JohnMismash/ECESeniorCapstone/Raspberry_Pi/ReadMe.txt

The program to run is mainProgram.py. To do this, python3 mainProgram.py

Wire Management:
Break Beam Sensor is using 
	GPIO 0, pin 11
	5 VDC, pin 2
	Ground, pin 6

Alarm Wires:
Alarm System is using:
	3.3 VDC Power, pin 1 
	GPIO 8, pin 3
	GPIO 9, pin 5
	Ground, pin 11
