JohnMismash/ECESeniorCapstone/Motor Calculations/PCB Planning.pdf

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

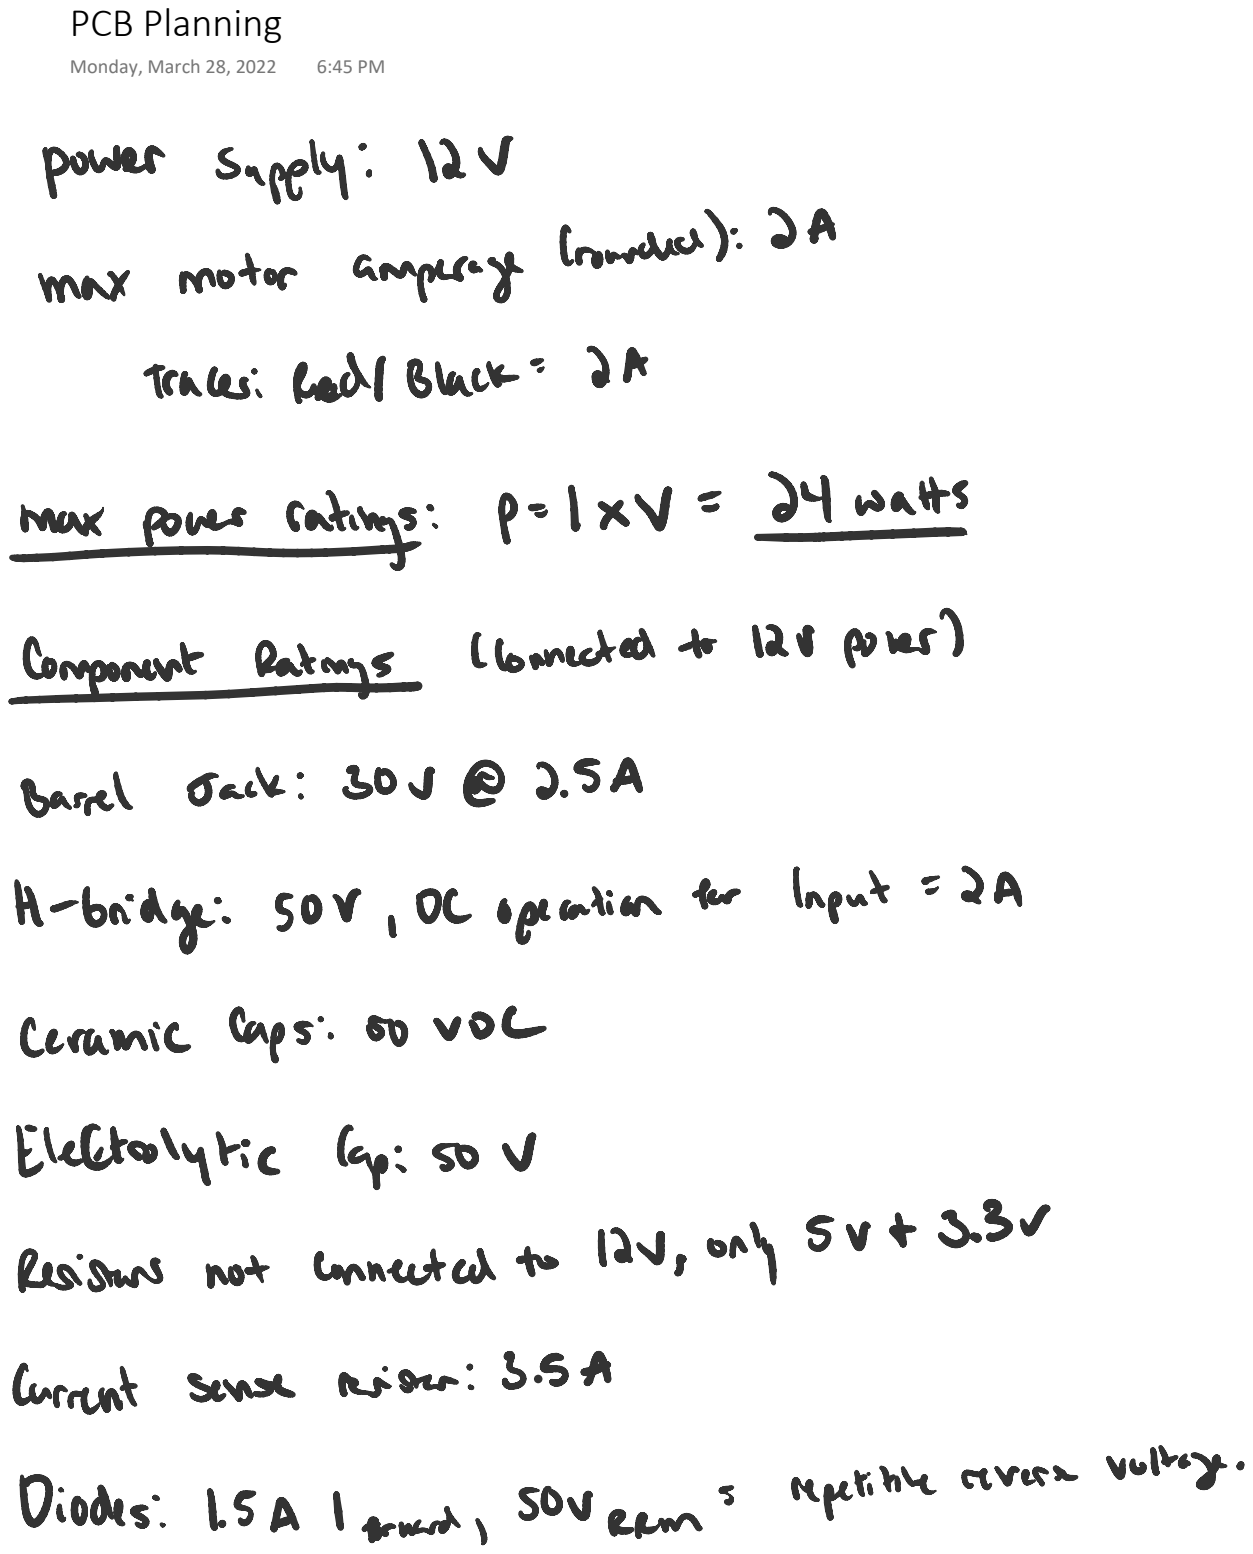
[picture p4: page 1]

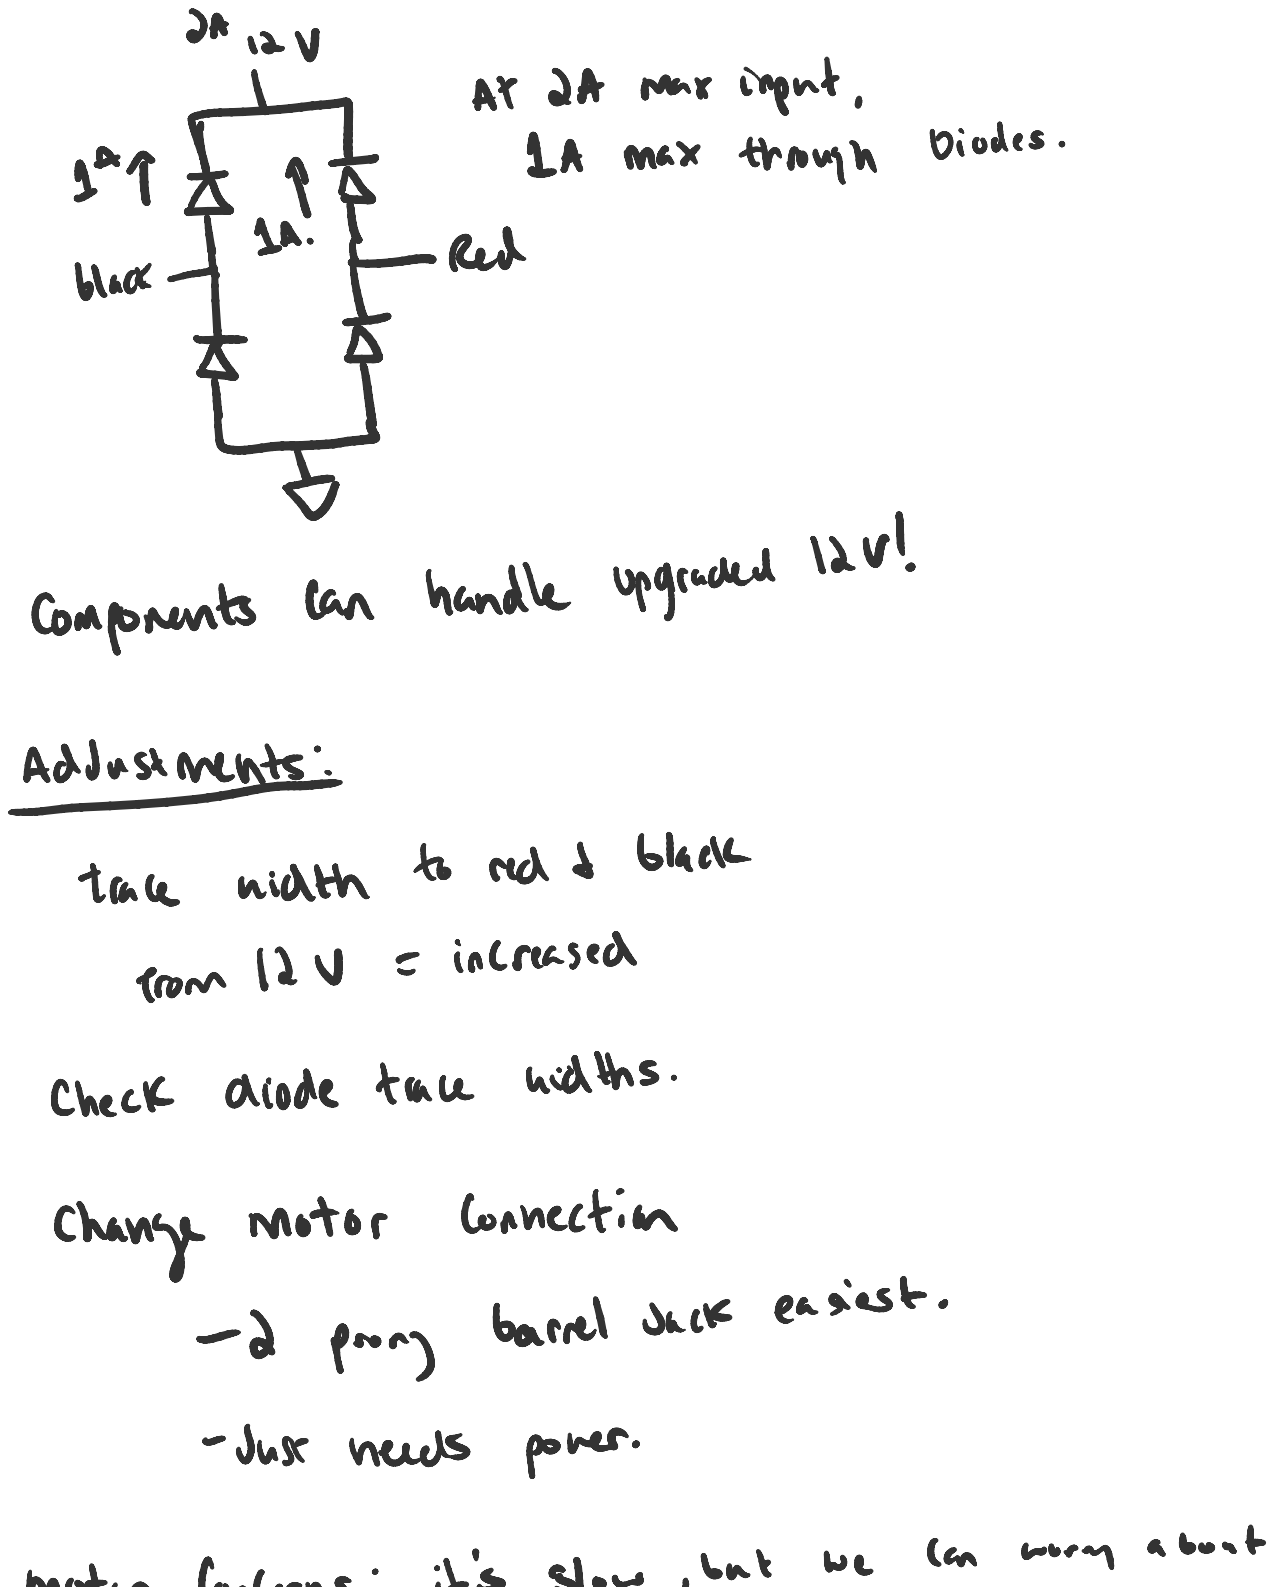
[picture p5: page 2]

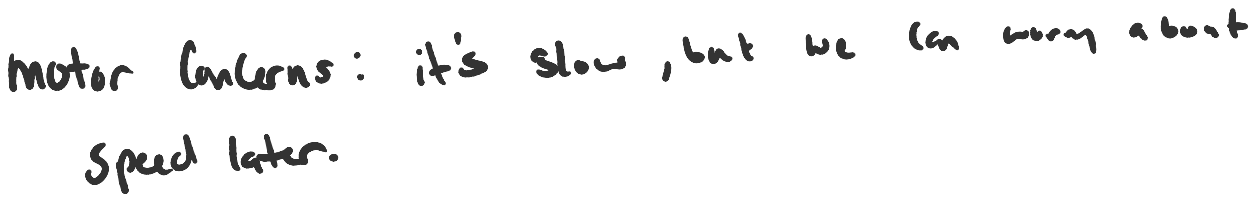
[picture p6: page 3]
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
