JohnMismash/ECESeniorCapstone/Alarm/STM_Alarm/Block_Diagram.png

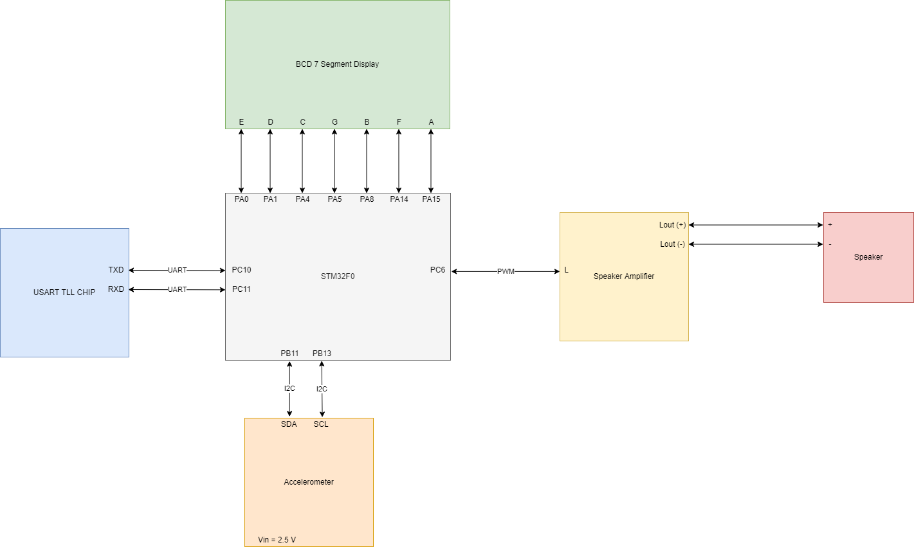
Alarm/STM_Alarm/Block_Diagram.png
