JohnMismash/ECESeniorCapstone/Motor Calculations/ECE3992FinalProject.png

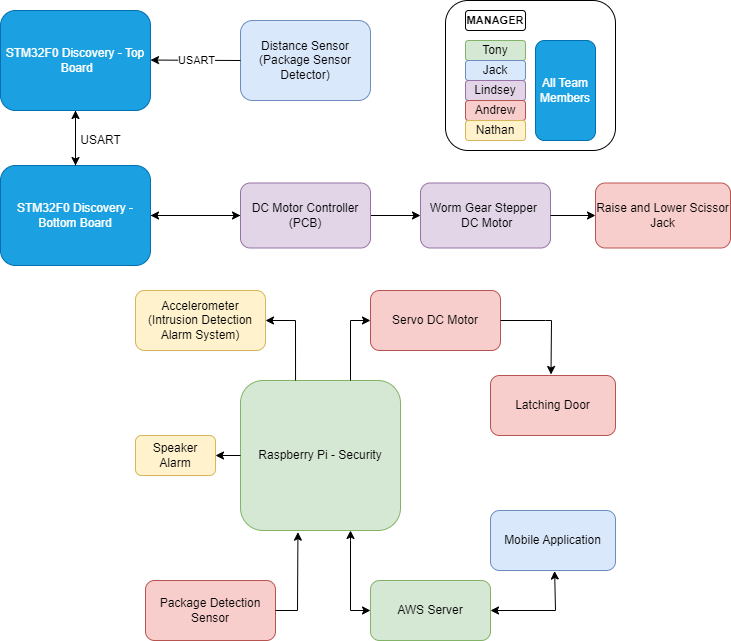
Motor Calculations/ECE3992FinalProject.png
