JohnMismash/ECESeniorCapstone/(list of files, cad)

Other CAD files:
PCB/MotorBoard v29.f3z
