JohnMismash/ECESeniorCapstone/Sensor Testing/Distance Sensor Test - Arduino/DistanceSensorOutput.PNG

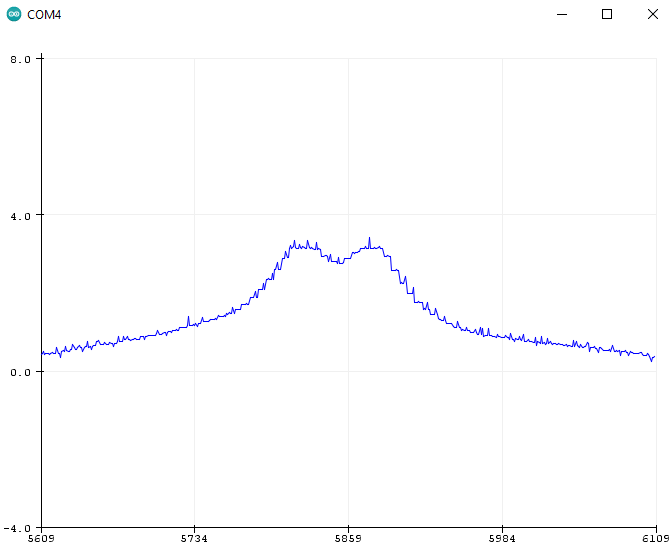
Sensor Testing/Distance Sensor Test - Arduino/DistanceSensorOutput.PNG
