JohnMismash/ECESeniorCapstone/PCB/MotorPCBSchematic.pdf

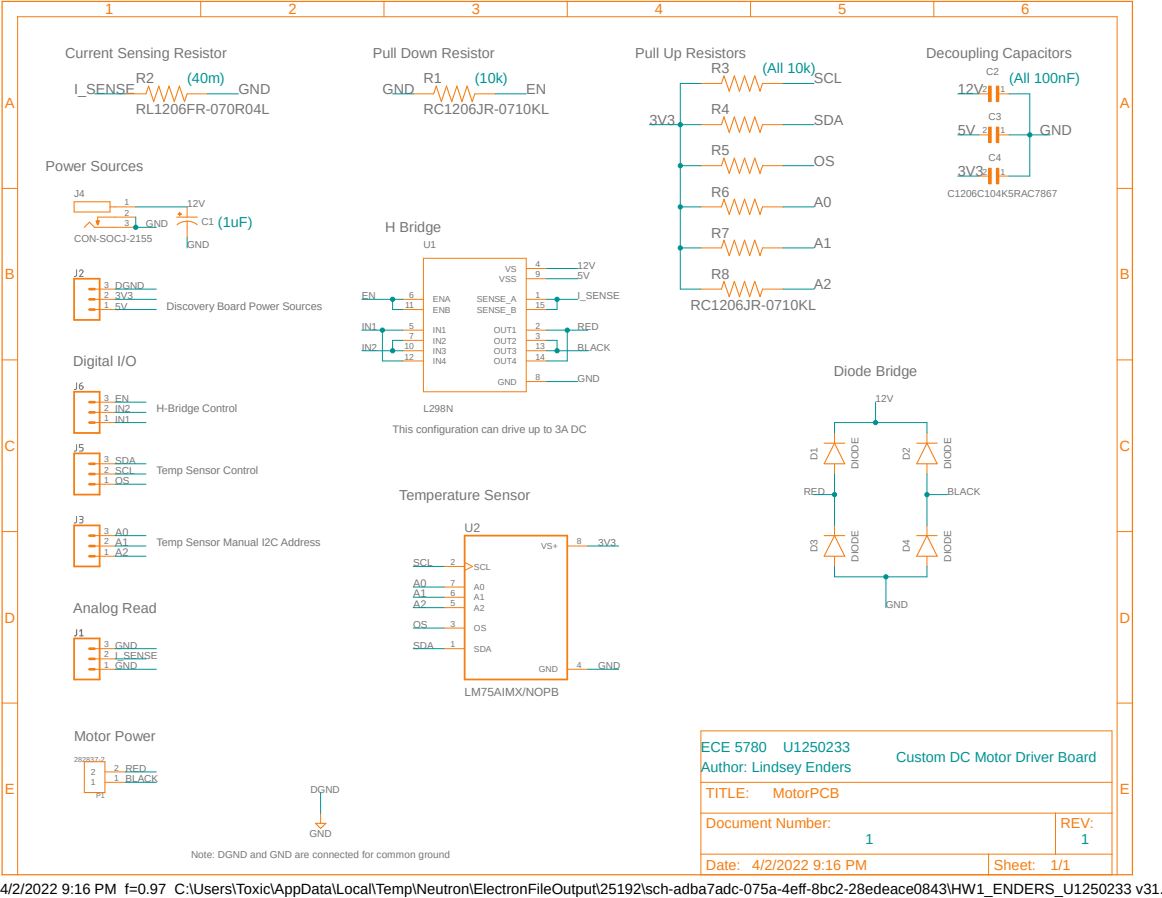
[picture p10: page 1]

Discovery Board Power Sources

This configuration can drive up to 3A DC

Temp Sensor Manual I2C Address

Document Number: 1 1 | REV:

Note: DGND and GND are connected for common ground

Date: 4/2/2022 9:16 PM | Sheet: 1/1

4/2/2022 9:16 PM f=0.97 C:\Users\Toxic\AppData\Local\Temp\Neutron\ElectronFileOutput\25192\sch-adba7adc-075a-4eff-8bc2-28edeace0843\HW1_ENDERS_U1250233 v31.sch (Sheet: 1/1)
