JohnMismash/ECESeniorCapstone/Sensor Testing/Distance Sensor Test - Arduino/Write Up.pdf

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

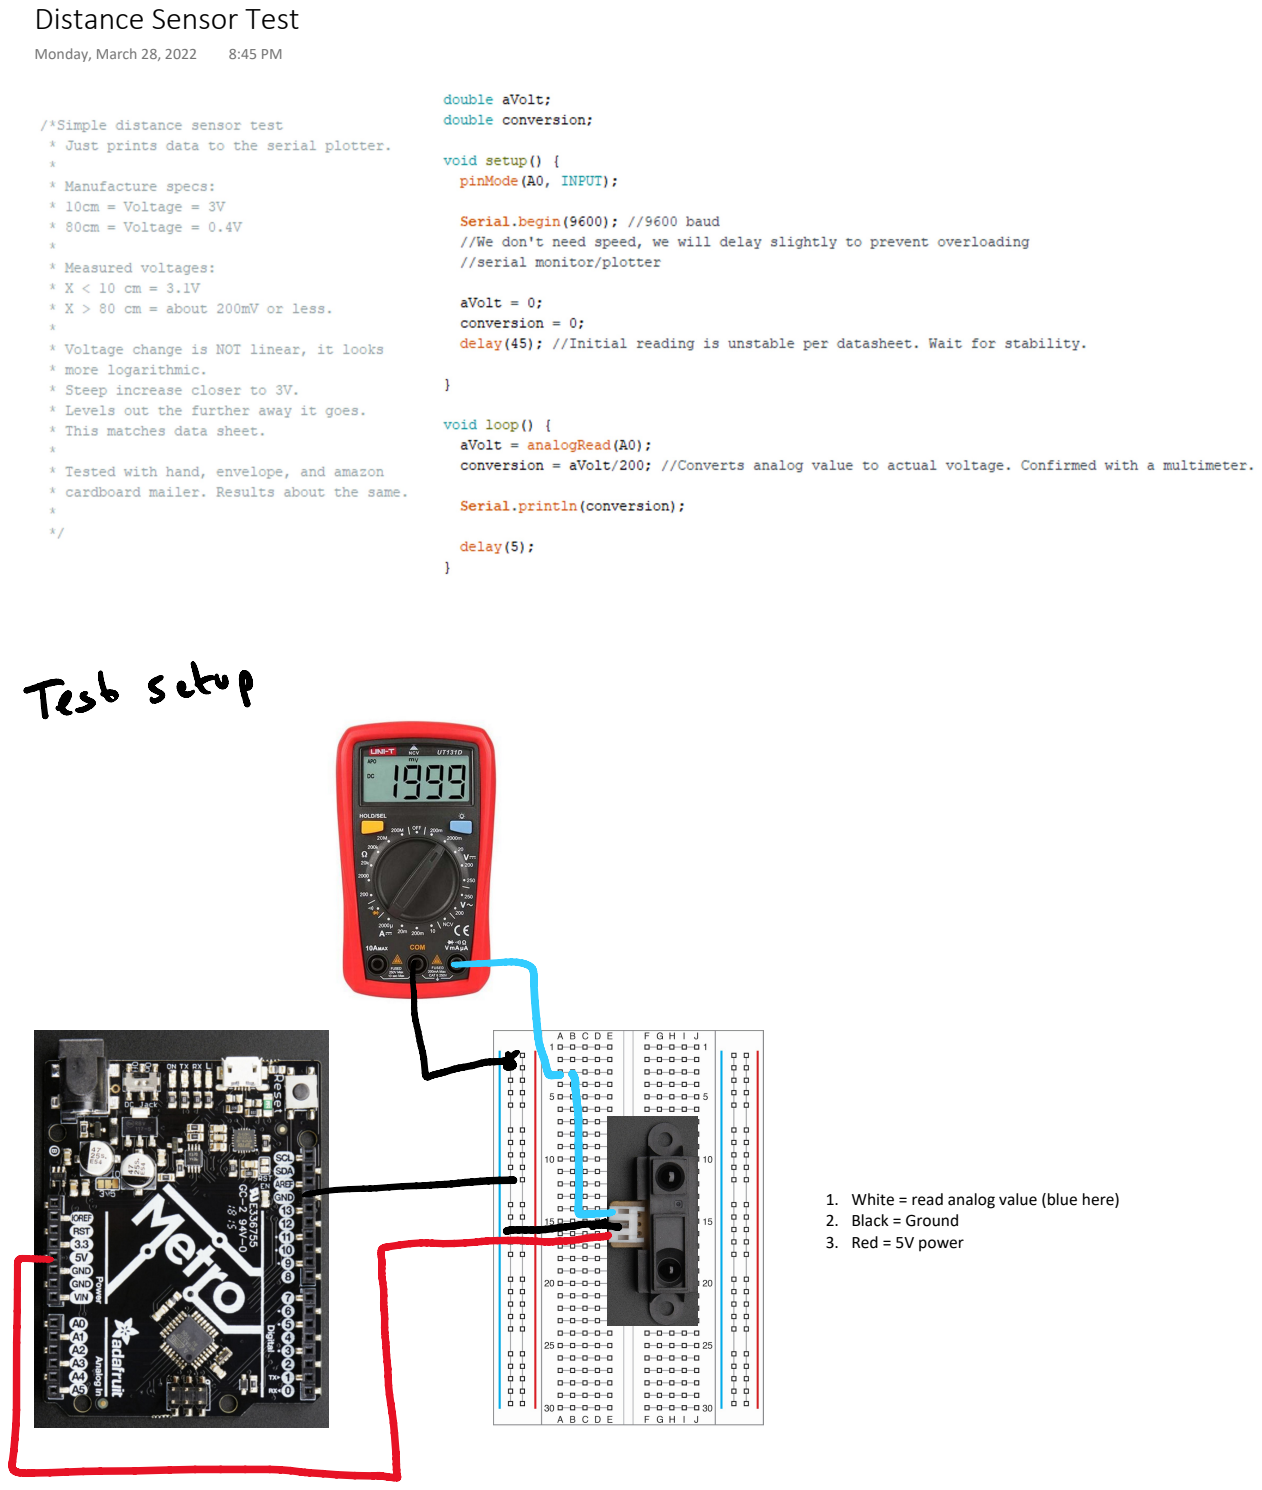
[picture p11: page 1]

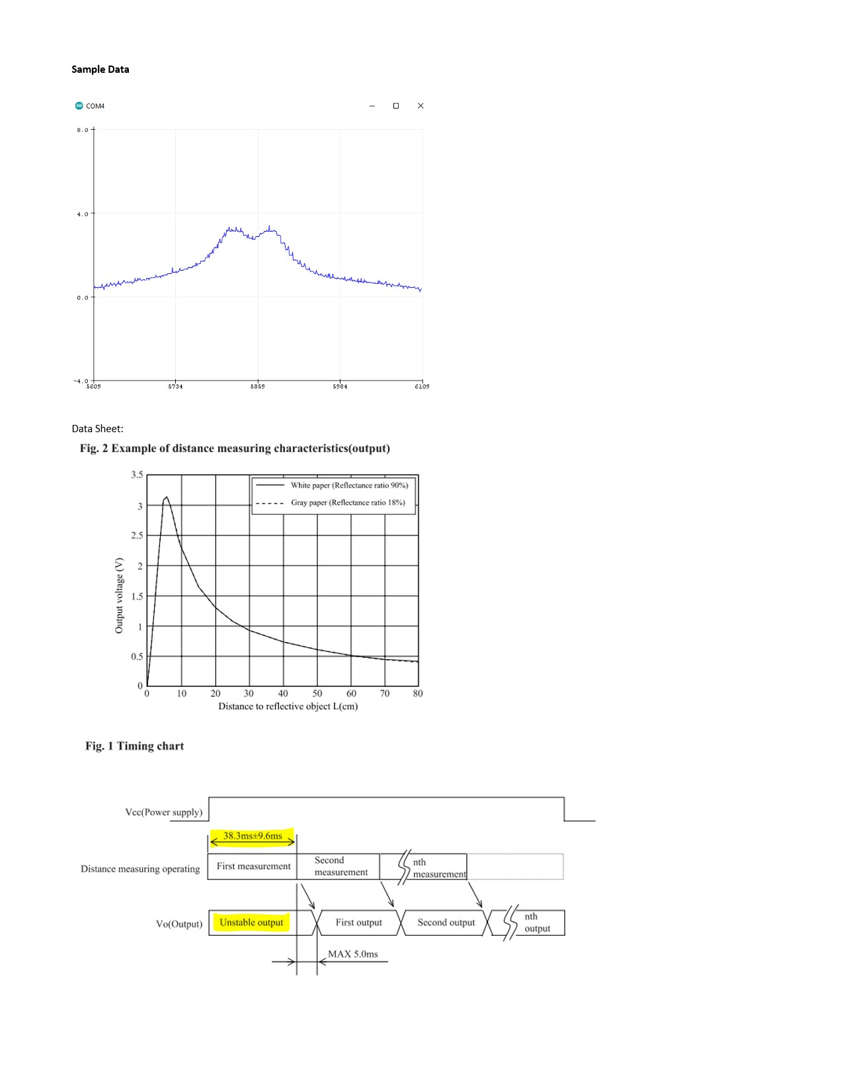
[picture p12: page 2]
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
