JohnMismash/ECESeniorCapstone/Sensor Testing/Limit Switch/Basic Limit Switch Test and Details.pdf

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

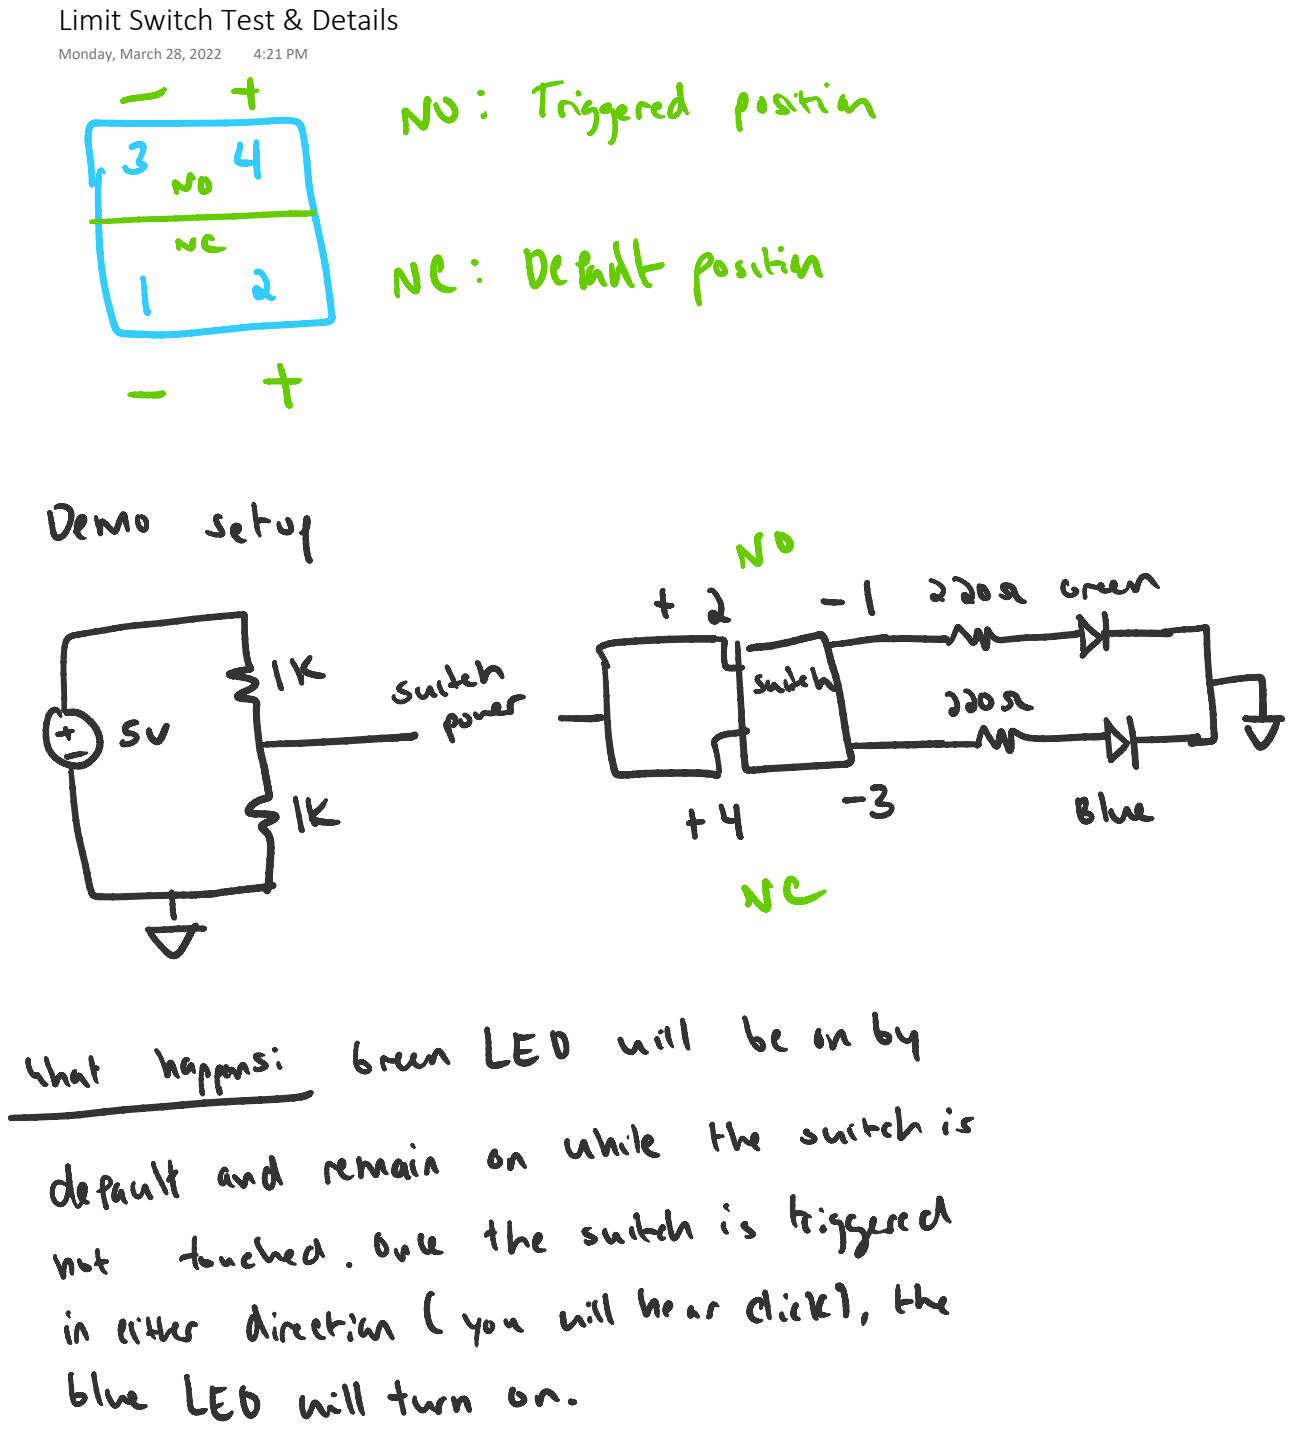
[picture p13: page 1]

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

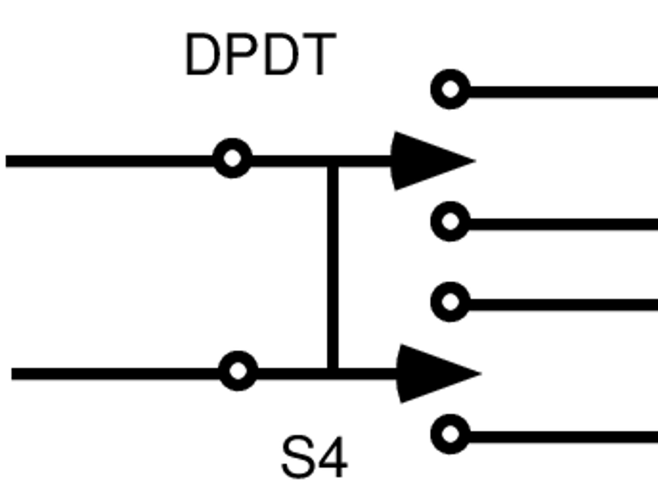
[picture p14: figure]
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
