JohnMismash/ECESeniorCapstone/PCB/RPIHub.pdf

RC1206JR-0710KL | RC1206JR-0710KL
R2 | R1

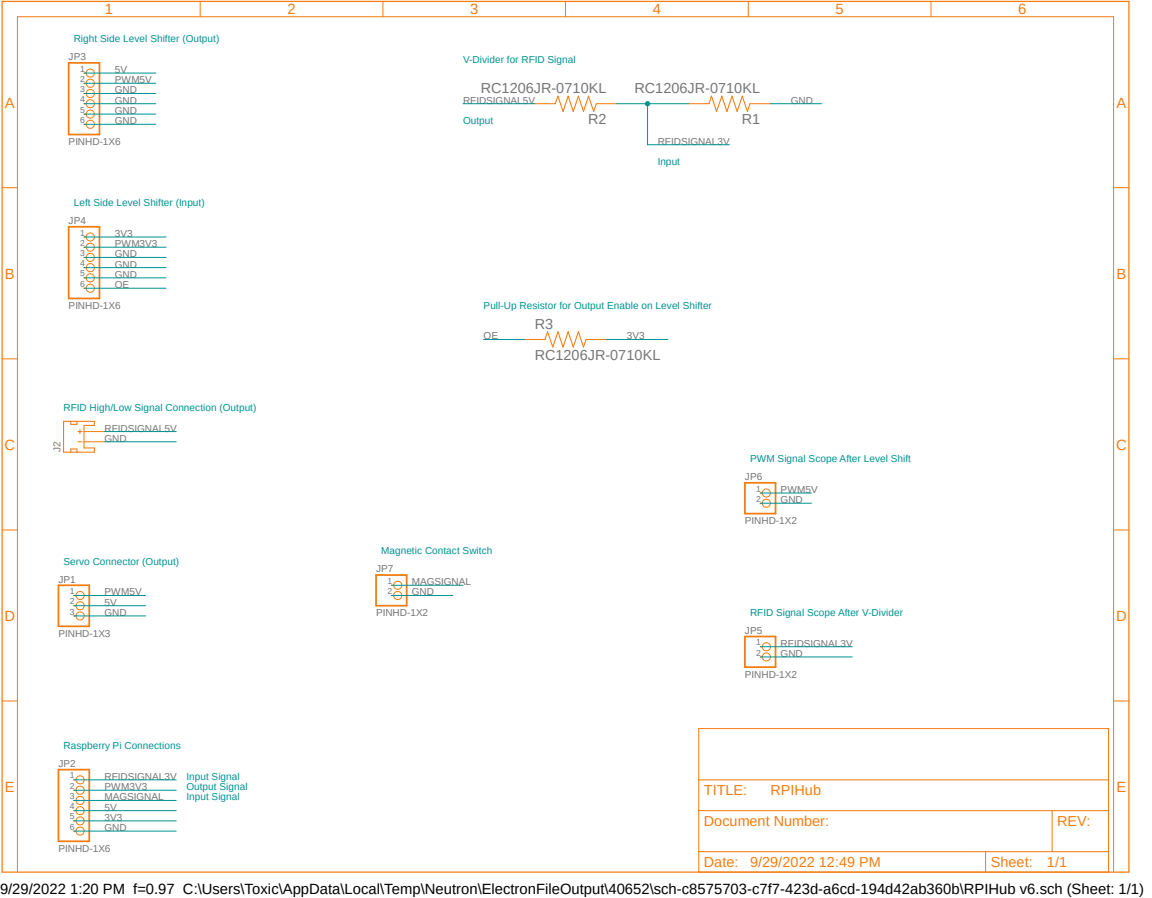
[picture p15: page 1]

V-Divider for RFID Signal

Pull-Up Resistor for Output Enable on Level Shifter

RFID High/Low Signal Connection (Output)

Document Number: | REV:

Date: 9/29/2022 12:49 PM | Sheet: 1/1

9/29/2022 1:20 PM f=0.97 C:\Users\Toxic\AppData\Local\Temp\Neutron\ElectronFileOutput\40652\sch-c8575703-c7f7-423d-a6cd-194d42ab360b\RPIHub v6.sch (Sheet: 1/1)
