JohnMismash/ECESeniorCapstone/Motor Calculations/LiftingCalculations.pdf

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

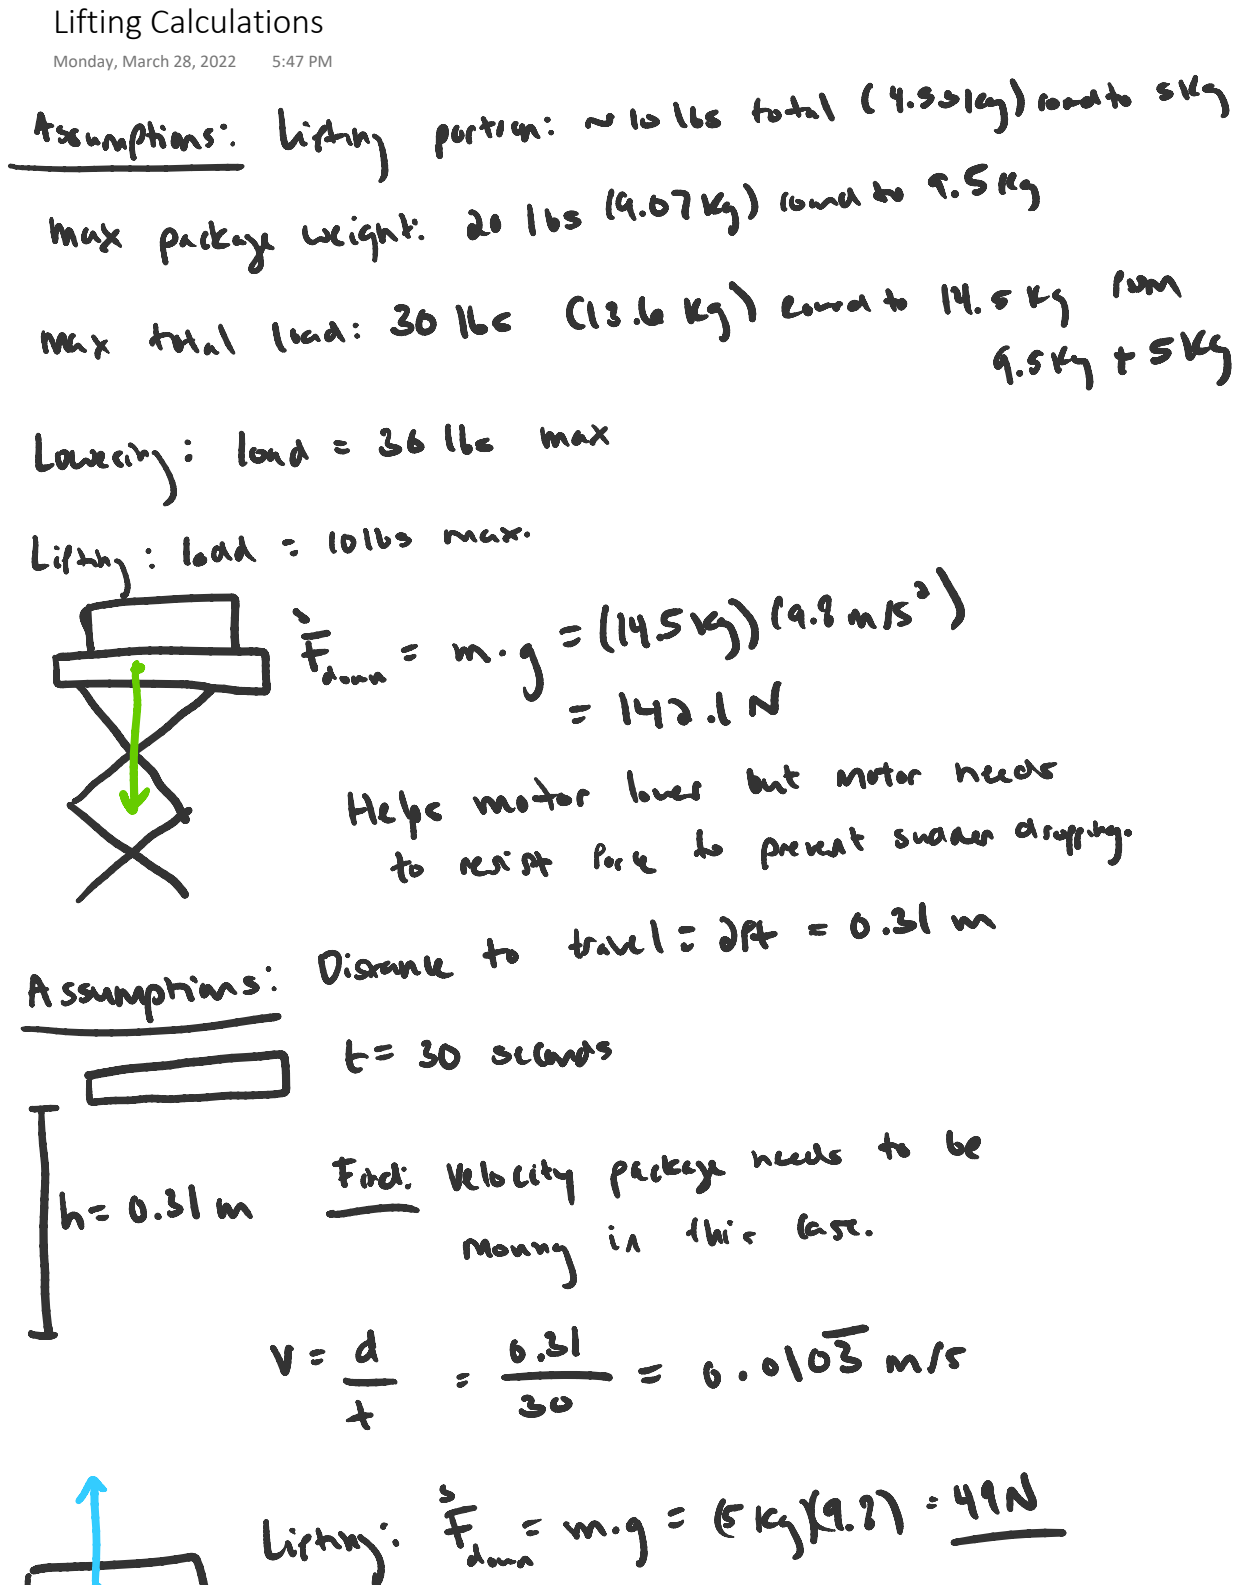
[picture p16: page 1]

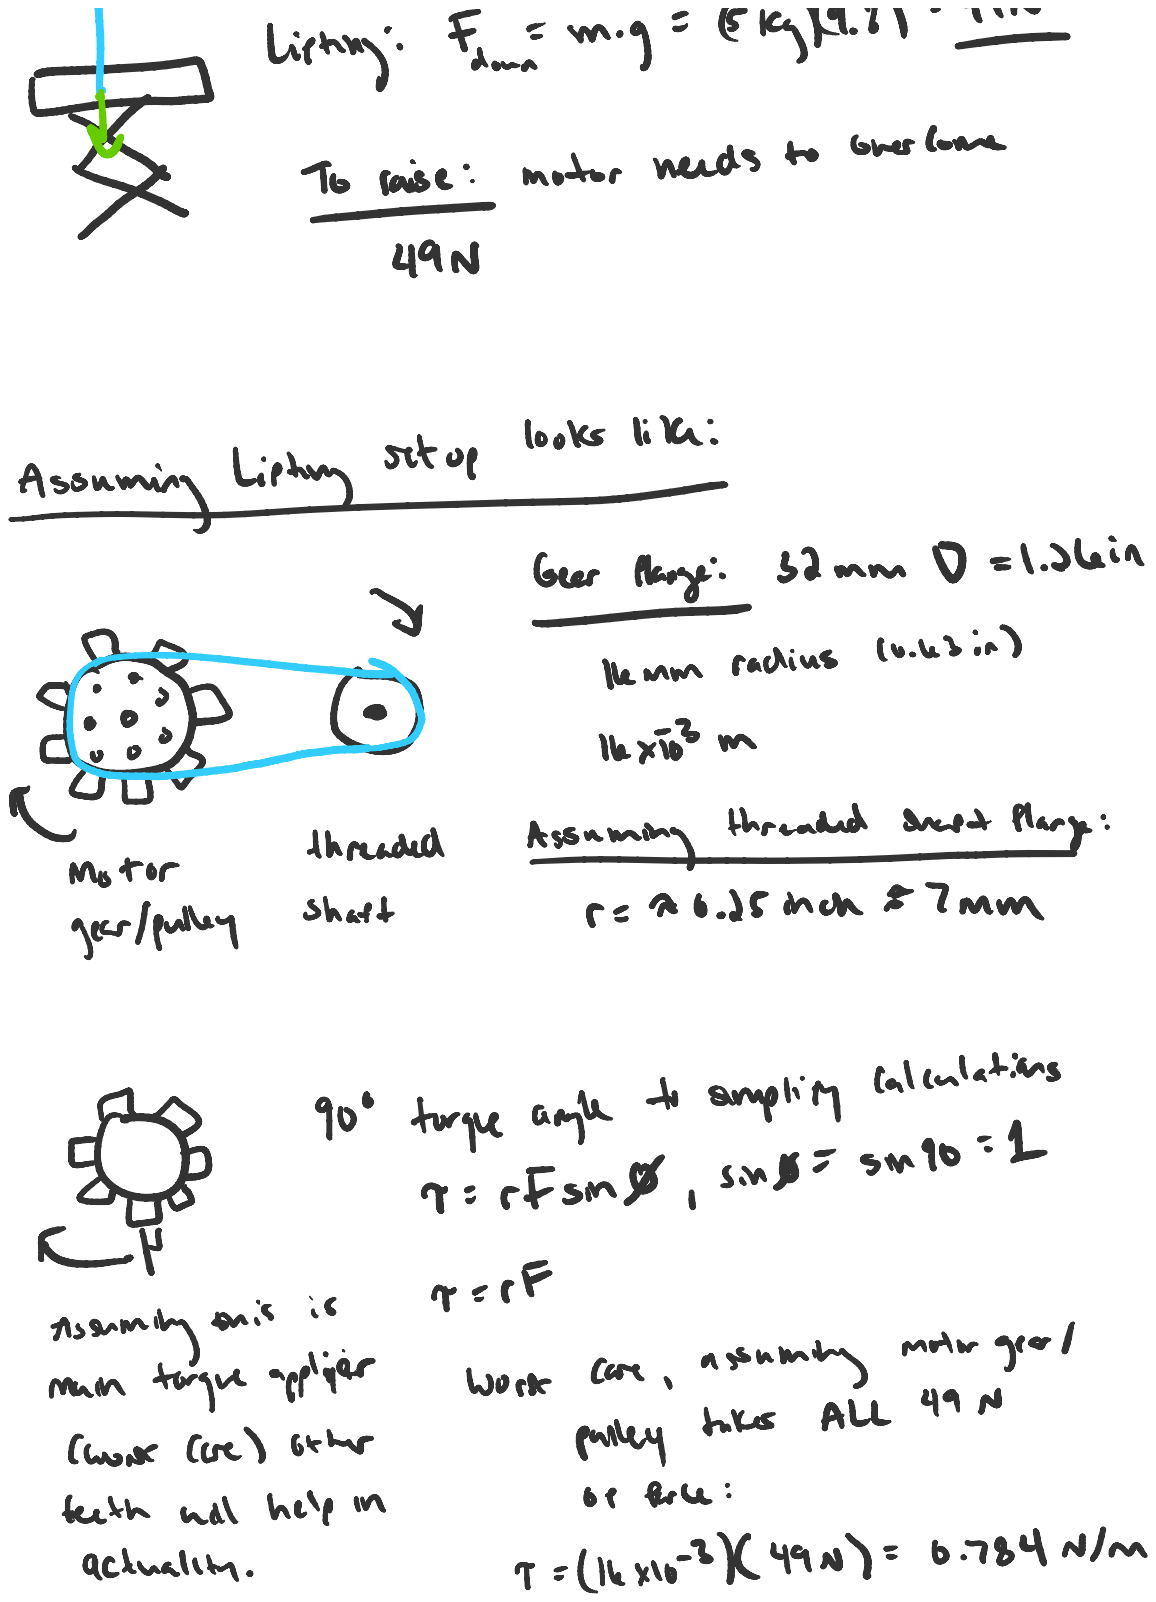
[picture p17: page 2]

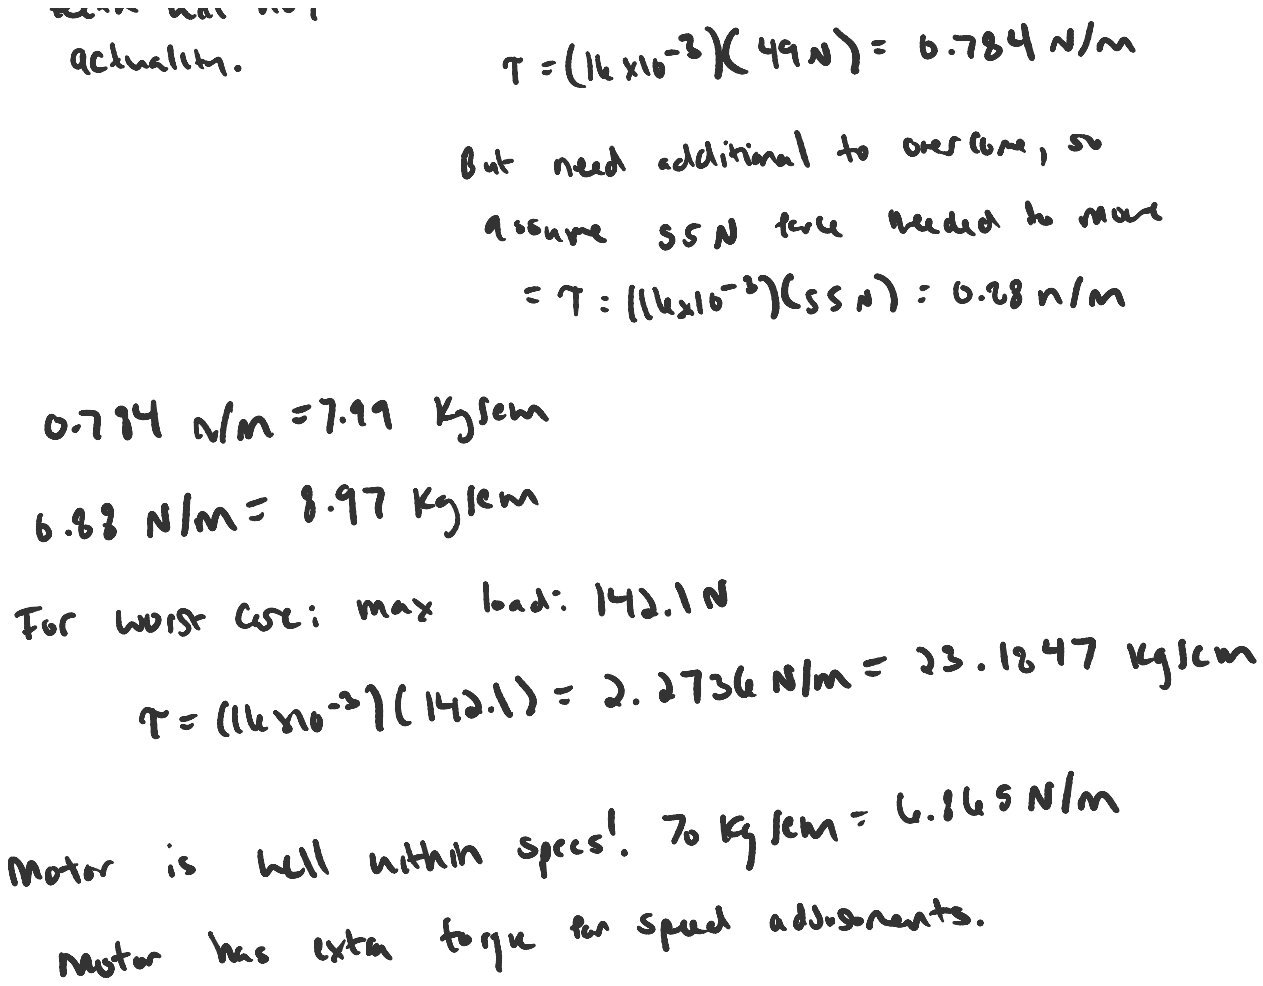
[picture p18: page 3]
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
