JohnMismash/ECESeniorCapstone/ECE5780/Bottom_STM/Core/Src/main.c

/* USER CODE BEGIN Header */
/** ECE 3992/4710 FINAL PROJECT CODE - BOTTOM MICROCONTROLLER BOARD

PIN ASSIGNMENT:
PB10/PB11 - USART Interface
PA0 - BOTTOM Limit Switch Signal Pin
PA1 - TOP Limit Switch Signal Pin
PC6-9 - LED Pins

---------------------------------------------------------------------------
HOW	TO WIRE THE BOTTOM LIMIT SWITCH:
1. Black wire goes to PA0 (It is NOT grounded!)
2. Yellow wire goes to 3V pin on board
---------------------------------------------------------------------------

---------------------------------------------------------------------------
HOW	TO WIRE THE TOP LIMIT SWITCH:
1. Black wire goes to PA1 (It is NOT grounded!)
2. Yellow wire goes to 3V pin on *THE TOP STM BOARD*
---------------------------------------------------------------------------

---------------------------------------------------------------------------
HOW	TO WIRE THE UART CONNECTION:
1. Ground on top board goes to ground on bottom board
2. PB10 on Top Board goes to PB11 on Bottom Board
3. PB11 on Top Board goes to PB10 on Bottom Board
---------------------------------------------------------------------------

---------------------------------------------------------------------------
HOW TO WIRE THE MOTOR CONNECTION:
1. ENABLE on motor controller connects to PA4
2. INPUT 1 on the motor controller connects to PA5
3. INPUT 2 on the motor controller connects to PC0
4. Both grounds on the  motor controller connects to ground on the STM board.
5. 5 Volts on the motor controller connects to 5 volts on the STM board
---------------------------------------------------------------------------

V1 Implementation of Inter-board communication via USART.  Boards will speak to each other
		Testing will involve pressing a button to signal another STM board to turn on an LED

V2 Implementing Limit Switch to reset LED signal after USART connection is made.

V3 Integrating basic motor code and control with USART and limit switch triggers.

******************************************************************************
* @file           : main.c
* @brief          : Main program body for the BOTTOM microcontroller
* @authors				: John (Jack) Mismash, u1179865 - University of Utah - ECE 5780
*						  			Andrew Porter, u1071655 - University of Utah - ECE 5780
*						  			Tony Robinson, u0531330 - University of Utah - ECE 5780
*						  			Lindsey Enders, u1250233 - University of Utah - ECE 5780
******************************************************************************
* @attention
*
* Copyright (c) 2022 STMicroelectronics.
* All rights reserved.
*
* This software is licensed under terms that can be found in the LICENSE file
* in the root directory of this software component.
* If no LICENSE file comes with this software, it is provided AS-IS.
*
******************************************************************************
*/

/* USER CODE END Header */
/* Includes ------------------------------------------------------------------*/
#include "main.h"

/* USER CODE BEGIN Includes */

#include "motor.h"

/* USER CODE END Includes */


/* USER CODE BEGIN PV */
char START_MOTOR = 'S';
char STOP_MOTOR = 'X';
char REACHED_TOP = 'R';

char motorLower = 0; 
char motorLift = 0; //Flag that tells the system it can initiate lifting sequence.
char cycleTriggered = 0; //Prevents accidental limit switch trigger.

char readyForPackage = 1;
char processTopLimitSwitch = 0;
char processBottomLimitSwitch = 0;

char lifting = 0;
char lowering = 0;
	
/* USER CODE END PV */

void SystemClock_Config(void);

/* USER CODE BEGIN PFP */
void TransmitChar (char );
void TransmitString (char* );
void TransmitToTopBoard(char);
void ReceiveFromTopBoard(uint8_t);
void LED_Init(void);
void USART_Init(void);
void Bottom_LimitSwitch_Init(void);

/* USER CODE END PFP */

/**
  * @brief  The application entry point.
  * @retval int
  */
int main(void)
{
  HAL_Init();
  SystemClock_Config();

  /* Initialize all configured peripherals */
	
  /* USER CODE BEGIN 2 */
  __HAL_RCC_GPIOA_CLK_ENABLE();	
  __HAL_RCC_GPIOB_CLK_ENABLE();
	__HAL_RCC_GPIOC_CLK_ENABLE();
	
  LED_Init();
  USART_Init();
  Bottom_LimitSwitch_Init();
	motor_init();
	
															 
  /* USER CODE END 2 */

  /* USER CODE BEGIN WHILE */
  while (1){

		/*
			Top board USART interrupt begins this whole process.
			
			This loop only toggles orange LED and then controls motor based on its state (lifting/lowering).
			Once its state has been processed, it ignores the limit switch. This prevents the interrupt starvation
			issue.
		*/
			
	  //HAL_Delay(200);
	  HAL_GPIO_TogglePin(GPIOC, GPIO_PIN_8); //Orange is waiting
		
		//LED Debugging help. Indicate which state we are in
		if (lifting) {
			HAL_GPIO_WritePin(GPIOC, GPIO_PIN_6, GPIO_PIN_SET); //Red
			HAL_GPIO_WritePin(GPIOC, GPIO_PIN_7, GPIO_PIN_RESET); //Blue off
		}
		
		if (lowering) {
			HAL_GPIO_WritePin(GPIOC, GPIO_PIN_7, GPIO_PIN_SET); //Blue
			HAL_GPIO_WritePin(GPIOC, GPIO_PIN_6, GPIO_PIN_RESET); //Red off
		}
		
		if(GPIOA->IDR & (1<<0)) { //Read PA0 value for bottom limit switch
			//We only care about the bottom limit switch when we are lowering.
			//Limit switch will read constant high for a bit while the lift raises.
			if (lowering) {
				//Stop the motor
				motor_hold();
				
				//Pause to allow the motor to stop.
				HAL_Delay(1000);
				
				//Switch motor to RAISE lift.
				motor_reverse();
				
				//Turn motor on.
				motor_run(10);
				
				//Indicate we are lifting
				lifting = 1;
				lowering = 0;
			}			
		}
  }
}

// INITIALIZE LED PINS
void LED_Init(void){
	
	// ENABLE THE GPIOC
	__HAL_RCC_GPIOC_CLK_ENABLE();

	// INIT LED PINS.
	GPIO_InitTypeDef initStrLED = {GPIO_PIN_6| GPIO_PIN_7 | GPIO_PIN_8 | GPIO_PIN_9,
									GPIO_MODE_OUTPUT_PP,
									GPIO_SPEED_FREQ_LOW,
									GPIO_NOPULL};
	
	// INIT PINS PC6, PC7, PC8 AND PC9.
	HAL_GPIO_Init(GPIOC, &initStrLED); 
}

// INITIALIZE USART INTERFACE
void USART_Init(void){
	__HAL_RCC_USART3_CLK_ENABLE();
	
	// INITIALIZE THE TX LINE.
	GPIO_InitTypeDef initStr = {GPIO_PIN_10,
								GPIO_MODE_AF_PP,
								GPIO_SPEED_FREQ_LOW,
								GPIO_NOPULL};
	
	// INITIALIZE THE RX LINE.
	GPIO_InitTypeDef initStr1 = {GPIO_PIN_11,
								 GPIO_MODE_AF_PP,
								 GPIO_SPEED_FREQ_LOW,
								 GPIO_PULLUP};
	
	// INIT PIN 10 & 11.														 
	HAL_GPIO_Init(GPIOB, &initStr);
	HAL_GPIO_Init(GPIOB, &initStr1);
	
	// SETS ALTERNATE FUCTION 4 FOR PINS PB10 AND PB11
	GPIOB -> AFR[1] |= (1 << 10);
	GPIOB -> AFR[1] |= (1 << 14);

	// GET SYSTEM CLOCK FREQ.															
	HAL_RCC_GetHCLKFreq();
	
	// SET THE BAUD RATE TO 115200 BITS/SECOND
	USART3 -> BRR |= ((1 << 0) | (1 << 2) | (1 << 6));
															 
	// SETS THE USART ENABLE BIT 0 TO 1 (USART ENABLED).													 
	USART3 -> CR1 |= 1;

	// ENABLE TX AND RX
	USART3->CR1 |= (1 << 3);
	USART3->CR1 |= (1 << 2);
	
	// ENABLE THE USART
	USART3->CR1 |= (1 << 0);

	// ENABLE THE Receive Register Not Empty Interrupt (RNE)	.
	USART3 -> CR1 |= (1 << 5);
	
	// ENABLE THE USART PRIORITY IN THE NVIC.
	NVIC_EnableIRQ(USART3_4_IRQn);
}


// INITIALIZE LIMIT SWITCH INTERFACE
void Bottom_LimitSwitch_Init(void){

	// USE THE RCC TO ENABLE THE SYSCFG PERIPHERAL CLK
  __HAL_RCC_SYSCFG_CLK_ENABLE();

  // INIT PIN PA0 TO INPUT MODE.
  GPIO_InitTypeDef initStr = {GPIO_PIN_0,
															GPIO_MODE_INPUT,
															GPIO_SPEED_FREQ_LOW,
															GPIO_PULLUP};
	
  HAL_GPIO_Init(GPIOA, &initStr); // INIT PA0.

	/*
  EXTI -> IMR |= (1 << 0);         // CREATE AS A INTERRUPT SIGNAL, NOT EVENT SIGNAL.	
  EXTI -> RTSR |= (1 << 0);	     	 // ENABLES RISING TRIGGER EVENT FOR PA0.
	EXTI->FTSR &= ~(1 << 0); 						//DISABLE FALLING EDGE TRIGGER FOR PA1
	SYSCFG->EXTICR[0] &= ~(0xf << 0);  // ROUTE PA0 TO THE EXTI INPUT LINE 0 (EXTI0). Clear lower 4 bits of EXTICR register to select PA0.
  NVIC_EnableIRQ(EXTI0_1_IRQn);    // ENABLE THE EXTI INTERRUPT.	
															*/
}

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
