JohnMismash/ECESeniorCapstone/(commit log)

2022-03-24 Create main.c
    Began communication code for Top STM board (the one that controls the rollers).
    Tried defining MACROS but didnt seem to want to compile
    TODO: insert button trigger method to send signal
2022-03-24 Create main.c
    Created main file for Bottom_STM (Controlling the screw shaft)
    Tried to implement MACROS but is not working.
    Version goals listed at top of file
    TODO: Set up button trigger.
    [main.c]
2022-03-26 Initiated communication between top board to bottom board, no confirmation yet.
2022-03-28 USART Comm is established between top and bottom board.
2022-03-29 Distance sensor test.
    Review distance sensor values based on movement. Documented testing procedure. Confirmed conversion from the raw A0 input value. We may need to adjust this on other boards, but we can use the same multimeter setup to help determine the conversion factor.
2022-03-29 Basic limit switch test and details
2022-03-29 Motor Calculations
2022-04-02 added sensor code
2022-04-03 working on uart
2022-04-03 fixed uart code. Boards are talking
    [main.c]
2022-04-06 Created interrupt handler for the limit switch.
2022-04-06 turn off LED in bottom board interupt handler
2022-04-06 Limit switch is integrated into the flow. Added comments of how to wire everything at the top of both main files. Cleaned up code
2022-04-07 Cleaned up comments, and fixed error within initialization.
    [main.c]
2022-04-08 Add motor control code
    Basic control code implemented. To be tested. Will need to be sequenced in main for our intended purposes, also will need to see whether lifting/lowering corresponds to forward/reverse direction. Temp sensor function headers have been declared but not implemented.
    [main.c, motor.c, motor.h]
2022-04-18 limit switch for top board
2022-04-18 Add in some motor and limit switch control
2022-04-18 Working bottom board code
2022-04-18 Cleaned up code, added connection details
    TO DO: Test PWM with functioning pins, investigate I_SENSE values, final motor code clean up.
2022-04-19 Clean up motor.c to only zero out bits for PC0, PA4 and PA5.
2022-04-21 Added in flag to prevent the system from raising again
    [main.c]
2022-04-23 added to top board code. Allow the distence sensor to be re-enabled after the lift goes up and down
2022-04-23 added comments to bottom board
2022-04-24 Adjustments to prevent interrupt starvation issue
    [main.c]
2022-04-30 Add PCB files
    [MotorBoard v29.f3z]
2022-06-11 Got Accelerometer to read x values and WHO AM I Transfer
2022-08-28 Generated PWM Signal and Folder for the DOOR
2022-09-09 Learning PWM and starting to learn GPIO
2022-09-10 Can read input voltages with Rasberry Pi
2022-09-10 Configuring Servo, start and change, but dont call stop
2022-09-16 PWM and RFID working
2022-10-15 Added Magnet sensor and integrating PWM RFID and Magnet Sensor
2022-11-05 Create sound module and integrate with app. Fix door function call name
    [alarm.py, door.py, mainProgram.py, shaking_pp_alarm.py, sounds.py, testDoor.py]
2022-11-05 door stuff working, but breakbeam sensor currently disabled due to different gpio setup from door
2022-11-19 Get X, Y and Z values for accelerometer by moving box
2022-11-20 FIX A BUG THAT DOES NOT EXIST
    [Config_Servo_PWM.py, Learning_PWM_RFID.py, Learning_PWM_RFID_Magnet_Sensor.py]
2022-11-22 Changed folder name to raspberry
2022-11-26 Fix interrupt timing to bottom board
    Allow repeated lifting/lowering by reorganizing interrupt timing.
    [main.c]
2022-11-26 Fix interrupt issue
    Reorder interrupts to allow bottom board to process stopping/reinstating bottom limit switch interrupt.
    [main.c]
2022-11-26 I uploaded the top board code to the bottom board
    Fixed and replaced with bottom board code
    [main.c]
2022-11-30 Reworked lift code
    Moved both limit switches to the bottom. Changed from interrupts to simple reads. Added some state variables to keep track of lifting/lowering. Added some LEDs to help with state debugging. Top board now only handles distance sensor. It will not pay attention to distance sensor values until after the lift is back in place (it receives a READY from bottom board)
    [main.c, motor.c, motor.h]
2022-11-30 Bug at line 186 of Bottom Board. Flag is not triggering but always triggers true with pin B0 but not pin B1 or A1
    [main.c]
2022-12-01 Fixed bug where A0 PIN not reading upper limit switch. Fixed with a hex number rather than BitShift notation
    [main.c]
